OBikePadmal/pslab-mini-hardware/schematic/pslab-mini.kicad_sch

## KiCad design schematic/pslab-mini.kicad_sch (2025-08-20)

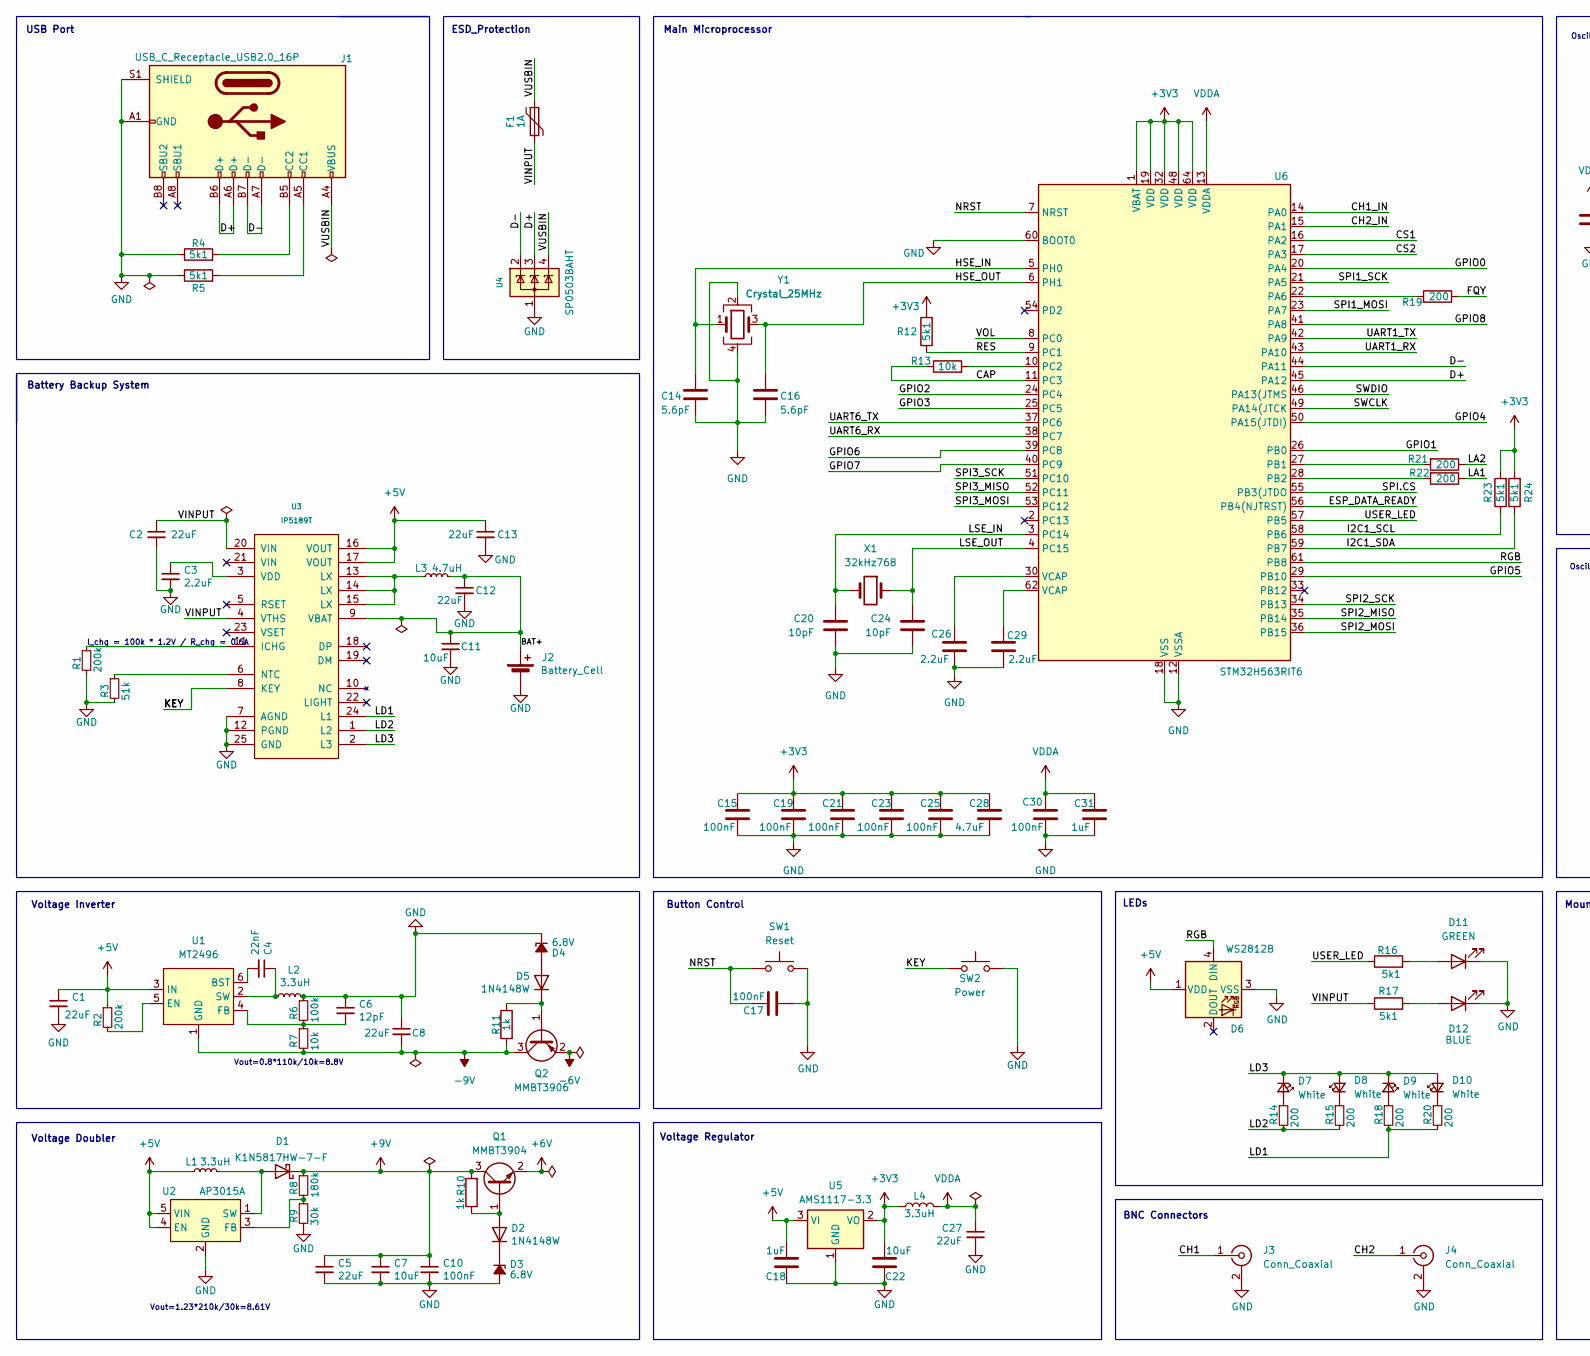
[picture p1: schematic pslab-mini.kicad_sch, part in row 1, column 1]

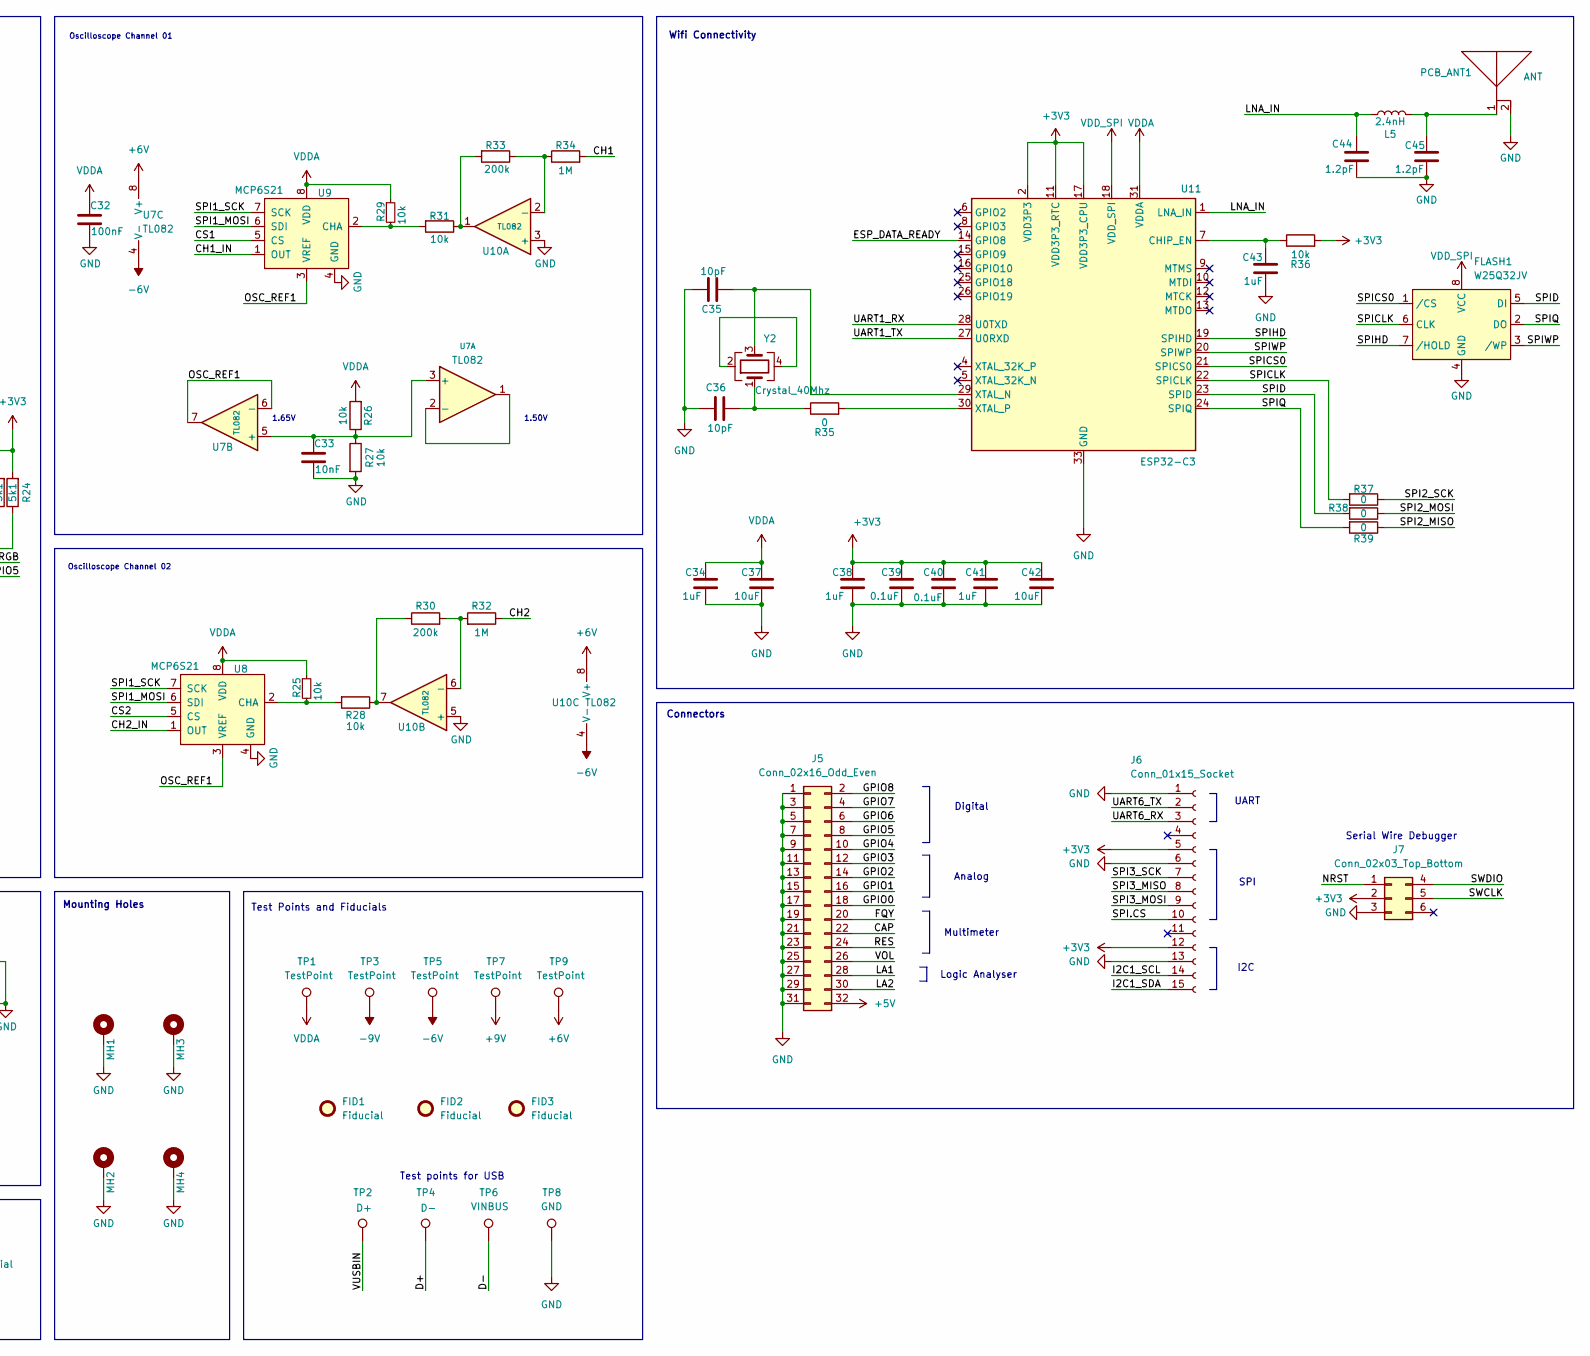
[picture p2: schematic pslab-mini.kicad_sch, part in row 1, column 2]

Parts:
C1, C2, C5, C8, C12, C13, C27: 22uF; C_0805_2012Metric; Part Number (LCSC) C602037
C3, C26, C29: 2.2uF; C_0805_2012Metric; Part Number (LCSC) C19110
C4: 22nF; C_0603_1608Metric; Part Number (LCSC) C21122
C6: 12pF; C_0603_1608Metric; Part Number (LCSC) C107034
C7, C11, C22, C37, C42: 10uF; C_0805_2012Metric; Part Number (LCSC) C1713
C10, C15, C17, C19, C21, C23, C25, C30, C32: 100nF; C_0603_1608Metric; Part Number (LCSC) C14663
C14, C16: 5.6pF; C_0603_1608Metric; Part Number (LCSC) C309464
C18, C31, C34, C38, C41, C43: 1uF; C_0603_1608Metric; Part Number (LCSC) C15849
C20, C24, C35, C36: 10pF; C_0603_1608Metric; Part Number (LCSC) C1634
C28: 4.7uF; C_0805_2012Metric; Part Number (LCSC) C98192
C33: 10nF; C_0603_1608Metric; Part Number (LCSC) C100042
C39, C40: 0.1uF; C_0603_1608Metric; Part Number (LCSC) C14663
C44, C45: 1.2pF; C_0603_1608Metric; Part Number (LCSC) C519098
D1: K1N5817HW-7-F; D_SOD-123; Part Number (LCSC) C2891703
D2, D5: 1N4148W; D_SOD-123; Part Number (LCSC) C241939
D3, D4: 6.8V; D_SOD-123; Part Number (LCSC) C132794
D6: WS2812B; LED_WS2812B_PLCC4_5.0x5.0mm_P3.2mm; Part Number (LCSC) C114586
D7, D8, D9, D10: White; LED_0603_1608Metric; Part Number (LCSC) C965808
D11: GREEN; LED_0805_2012Metric; Part Number (LCSC) C965815
D12: BLUE; LED_0805_2012Metric; Part Number (LCSC) C965817
F1: 1A; Fuse_1206_3216Metric; Part Number (LCSC) C22435907
FID1, FID2, FID3: Fiducial; Fiducial_0.5mm_Mask1.5mm
FLASH1: W25Q32JV; SOIC-8_5.3x5.3mm_P1.27mm; Part Number (LCSC) C179173
J1: USB_C_Receptacle_USB2.0_16P; USB_C_Receptacle_G-Switch_GT-USB-7010ASV; Part Number (LCSC) C2988369
J2: Battery_Cell; 2.0mm_connector_edge; Part Number (LCSC) C295747
J3, J4: Conn_Coaxial; BNC_connector_dosinconn DOSIN-801-0050; Part Number (LCSC) C521210
J5: Conn_02x16_Odd_Even; PinSocket_2x16_P2.54mm_Vertical; Part Number (LCSC) C2883989
J6: Conn_01x15_Socket; PinSocket_1x15_P2.54mm_Vertical; Part Number (LCSC) C2932676
J7: Conn_02x03_Top_Bottom; pslab-mini_2x03_P2.54mm
L1, L2, L4: 3.3uH; L_0603_1608Metric; Part Number (LCSC) C162581
L3: 4.7uH; L_0805_2012Metric; Part Number (LCSC) C131082
L5: 2.4nH; L_0402_1005Metric; Part Number (LCSC) C404619
MH1, MH2, MH3, MH4: MountingHole_Pad; MountingHole_2.75mm_Pad
PCB_ANT1: ANT; D_1206_3216Metric; Part Number (LCSC) C127620
Q1: MMBT3904; SOT-23; Part Number (LCSC) C81464
Q2: MMBT3906; SOT-23; Part Number (LCSC) C727128
R1, R2, R30, R33: 200k; R_0603_1608Metric; Part Number (LCSC) C105574
R3: 51k; R_0603_1608Metric; Part Number (LCSC) C107231
R4, R5, R12, R16, R17, R23, R24: 5k1; R_0603_1608Metric; Part Number (LCSC) C105580
R6: 100k; R_0603_1608Metric; Part Number (LCSC) C14675
R7, R13, R25, R26, R27, R28, R29, R31, R36: 10k; R_0603_1608Metric; Part Number (LCSC) C98220
R8: 180k; R_0603_1608Metric; Part Number (LCSC) C123419
R9: 30k; R_0603_1608Metric; Part Number (LCSC) C723585
R10, R11: 1k; R_0603_1608Metric; Part Number (LCSC) C22548
R14, R15, R18, R20: 200; R_0402_1005Metric; Part Number (LCSC) C114764
R19, R21, R22: 200; R_0603_1608Metric; Part Number (LCSC) C114664
R32, R34: 1M; R_0603_1608Metric; Part Number (LCSC) C105578
R35, R37, R38, R39: 0; R_0603_1608Metric; Part Number (LCSC) C95177
SW1: Reset; SW_Tactile_SPST_NO_Straight_CK_PTS636Sx25SMTRLFS; Part Number (LCSC) C2689642
SW2: Power; SW_Tactile_SPST_NO_Straight_CK_PTS636Sx25SMTRLFS; Part Number (LCSC) C2689642
TP1, TP3, TP5, TP7, TP9: TestPoint; Test_Point_0.8mm
TP2: D+; TestPoint_Pad_1.0x1.0mm
TP4: D-; TestPoint_Pad_1.0x1.0mm
TP6: VINBUS; TestPoint_Pad_1.0x1.0mm
TP8: GND; TestPoint_Pad_1.0x1.0mm
U1: MT2496; SOT-23-6; Part Number (LCSC) C384594
U2: AP3015A; SOT-23-5; Part Number (LCSC) C154879
U3: IP5189T; QFN-24-1EP_4x4mm_P0.5mm_EP2.6x2.6mm; Part Number (LCSC) C181698
U4: SP0503BAHT; SOT-143; Part Number (LCSC) C7074
U5: AMS1117-3.3; SOT-223-3_TabPin2; Part Number (LCSC) C6186
U6: STM32H563RIT6; LQFP-64_10x10mm_P0.5mm; Part Number (LCSC) C20619634
U7, U10: TL082; SOIC-8_3.9x4.9mm_P1.27mm; Part Number (LCSC) C9385
U8, U9: MCP6S21; SOIC-8_3.9x4.9mm_P1.27mm; Part Number (LCSC) C144187
U11: ESP32-C3; QFN-32-1EP_5x5mm_P0.5mm_EP3.7x3.7mm; Part Number (LCSC) C2838500
X1: 32kHz768; Crystal_SMD_3215-2Pin_3.2x1.5mm; Part Number (LCSC) C32346
Y1: Crystal_25MHz; Crystal_SMD_3225-4Pin_3.2x2.5mm; Part Number (LCSC) C9006
Y2: Crystal_40Mhz; Crystal_SMD_3225-4Pin_3.2x2.5mm; Part Number (LCSC) C5261245

Connections:
+3V3: C15.1, C19.1, C21.1, C22.2, C23.1, C25.1, C28.1, C38.1, C39.1, C40.1, C41.1, C42.1, J6.5, J6.12, J7.2, L4.2, R12.2, R23.2, R24.2, R36.2, U5.2 (VO), U6.1 (VBAT), U6.19 (VDD), U6.32 (VDD), U6.48 (VDD), U6.64 (VDD), U11.2 (VDD3P3), U11.3 (VDD3P3), U11.11 (VDD3P3_RTC), U11.17 (VDD3P3_CPU)
+5V: C1.1, C13.1, C18.2, D6.1 (VDD), J5.32, L1.1, R2.1, U1.3 (IN), U2.4 (EN), U2.5 (VIN), U3.16 (VOUT), U3.17 (VOUT), U5.3 (VI)
+6V: Q1.2 (E), TP9.1, U7.8 (V+), U10.8 (V+)
+9V: C5.1, C7.1, C10.1, D1.1 (K), Q1.3 (C), R8.1, R10.2, TP7.1
-6V: Q2.2 (E), TP5.1, U7.4 (V-), U10.4 (V-)
-9V: C8.2, Q2.3 (C), R7.2, R11.2, TP3.1, U1.1 (GND)
BAT+: C11.1, C12.1, J2.1 (+), L3.2, U3.9 (VBAT)
CAP: J5.22, R13.1, U6.11 (PC3)
CH1: J3.1 (In), R34.2
CH1_IN: U6.14 (PA0), U9.1 (OUT)
CH2: J4.1 (In), R32.1
CH2_IN: U6.15 (PA1), U8.1 (OUT)
CS1: U6.16 (PA2), U9.5 (CS)
CS2: U6.17 (PA3), U8.5 (CS)
D+: J1.A6 (D+), J1.B6 (D+), TP4.1, U4.3 (K), U6.45 (PA12)
D-: J1.A7 (D-), J1.B7 (D-), TP6.1, U4.2 (K), U6.44 (PA11)
ESP_DATA_READY: U6.56 (PB4(NJTRST)), U11.14 (GPIO8)
FQY: J5.20, R19.1
GND: C1.2, C2.2, C3.2, C5.2, C6.1, C7.2, C8.1, C10.2, C11.2, C12.2, C13.2, C14.2, C15.2, C16.2, C17.2, C18.1, C19.2, C20.2, C21.2, C22.1, C23.2, C24.2, C25.2, C26.2, C27.2, C28.2, C29.2, C30.2, C31.2, C32.2, C33.2, C34.2, C35.1, C36.1, C37.2, C38.2, C39.2, C40.2, C41.2, C42.2, C43.2, C44.2, C45.2, D3.2 (A), D4.1 (K), D6.3 (VSS), D11.1 (K), D12.1 (K), FLASH1.4 (GND), J1.A1 (GND), J1.A12 (GND), J1.B1 (GND), J1.B12 (GND), J1.S1 (SHIELD), J2.2 (-), J3.2 (Ext), J4.2 (Ext), J5.1, J5.3, J5.5, J5.7, J5.9, J5.11, J5.13, J5.15, J5.17, J5.19, J5.21, J5.23, J5.25, J5.27, J5.29, J5.31, J6.1, J6.6, J6.13, J7.3, L2.2, MH1.1, MH2.1, MH3.1, MH4.1, PCB_ANT1.2, R1.2, R3.2, R4.1, R5.1, R6.1, R9.2, R27.2, SW1.2, SW2.1, TP8.1, U2.2 (GND), U3.7 (AGND), U3.12 (PGND), U3.25 (GND), U4.1 (A), U5.1 (GND), U6.12 (VSSA), U6.18 (VSS), U6.31 (VSS), U6.47 (VSS), U6.60 (BOOT0), U6.63 (VSS), U8.4 (GND), U9.4 (GND), U10.3 (+), U10.5 (+), U11.33 (GND), Y1.2, Y1.4
GPIO0: J5.18, U6.20 (PA4)
GPIO1: J5.16, U6.26 (PB0)
GPIO2: J5.14, U6.24 (PC4)
GPIO3: J5.12, U6.25 (PC5)
GPIO4: J5.10, U6.50 (PA15(JTDI))
GPIO5: J5.8, U6.29 (PB10)
GPIO6: J5.6, U6.39 (PC8)
GPIO7: J5.4, U6.40 (PC9)
GPIO8: J5.2, U6.41 (PA8)
HSE_IN: C14.1, U6.5 (PH0), Y1.1
HSE_OUT: C16.1, U6.6 (PH1), Y1.3
I2C1_SCL: J6.14, R23.1, U6.58 (PB6)
I2C1_SDA: J6.15, R24.1, U6.59 (PB7)
KEY: SW2.2, U3.8 (KEY)
LA1: J5.28, R22.1
LA2: J5.30, R21.1
LD1: R18.2, R20.2, U3.24 (L1)
LD2: R14.2, R15.2, U3.1 (L2)
LD3: D7.1 (K), D8.2 (A), D9.1 (K), D10.2 (A), U3.2 (L3)
LNA_IN: C44.1, L5.2, U11.1 (LNA_IN)
LSE_IN: C20.1, U6.3 (PC14), X1.2
LSE_OUT: C24.1, U6.4 (PC15), X1.1
NRST: C17.1, J7.1, SW1.1, U6.7 (NRST)
unnamed: C3.1, U3.3 (VDD)
unnamed: C4.1, L2.1, U1.2 (SW)
unnamed: C4.2, U1.6 (BST)
unnamed: C6.2, R6.2, R7.1, U1.4 (FB)
unnamed: C26.1, U6.30 (VCAP)
unnamed: C29.1, U6.62 (VCAP)
unnamed: C33.1, R26.1, R27.1, U7.3 (+), U7.5 (+)
unnamed: C35.2, U11.29 (XTAL_N), Y2.3
unnamed: C36.2, R35.1, Y2.1
unnamed: C43.1, R36.1, U11.7 (CHIP_EN)
unnamed: C45.1, L5.1, PCB_ANT1.1
unnamed: D1.2 (A), L1.2, U2.1 (SW)
unnamed: D2.1 (K), D3.1 (K)
unnamed: D2.2 (A), Q1.1 (B), R10.1
unnamed: D4.2 (A), D5.2 (A)
unnamed: D5.1 (K), Q2.1 (B), R11.1
unnamed: D7.2 (A), R14.1
unnamed: D8.1 (K), R15.1
unnamed: D9.2 (A), R18.1
unnamed: D10.1 (K), R20.1
unnamed: D11.2 (A), R16.2
unnamed: D12.2 (A), R17.2
unnamed: J1.A5 (CC1), R5.2
unnamed: J1.B5 (CC2), R4.2
unnamed: L3.1, U3.13 (LX), U3.14 (LX), U3.15 (LX)
unnamed: R1.1, U3.11 (ICHG)
unnamed: R2.2, U1.5 (EN)
unnamed: R3.1, U3.6 (NTC)
unnamed: R8.2, R9.1, U2.3 (FB)
unnamed: R13.2, U6.10 (PC2)
unnamed: R19.2, U6.22 (PA6)
unnamed: R21.2, U6.27 (PB1)
unnamed: R22.2, U6.28 (PB2)
unnamed: R25.2, R28.2, U8.2 (CHA)
unnamed: R28.1, R30.1, U10.7
unnamed: R29.2, R31.2, U9.2 (CHA)
unnamed: R30.2, R32.2, U10.6 (-)
unnamed: R31.1, R33.2, U10.1
unnamed: R33.1, R34.1, U10.2 (-)
unnamed: R35.2, U11.30 (XTAL_P)
unnamed: U7.1, U7.2 (-)
unnamed: Y2.2, Y2.4
OSC_REF1: U7.6 (-), U7.7, U8.3 (VREF), U9.3 (VREF)
RES: J5.24, R12.1, U6.9 (PC1)
RGB: D6.4 (DIN), U6.61 (PB8)
SPI1_MOSI: U6.23 (PA7), U8.6 (SDI), U9.6 (SDI)
SPI1_SCK: U6.21 (PA5), U8.7 (SCK), U9.7 (SCK)
SPI2_MISO: R39.1, U6.35 (PB14)
SPI2_MOSI: R38.1, U6.36 (PB15)
SPI2_SCK: R37.1, U6.34 (PB13)
SPI3_MISO: J6.8, U6.52 (PC11)
SPI3_MOSI: J6.9, U6.53 (PC12)
SPI3_SCK: J6.7, U6.51 (PC10)
SPI.CS: J6.10, U6.55 (PB3(JTDO)
SPICLK: FLASH1.6 (CLK), R37.2, U11.22 (SPICLK)
SPICS0: FLASH1.1 (/CS), U11.21 (SPICS0)
SPID: FLASH1.5 (DI), R38.2, U11.23 (SPID)
SPIHD: FLASH1.7 (/HOLD), U11.19 (SPIHD)
SPIQ: FLASH1.2 (DO), R39.2, U11.24 (SPIQ)
SPIWP: FLASH1.3 (/WP), U11.20 (SPIWP)
SWCLK: J7.5, U6.49 (PA14(JTCK)
SWDIO: J7.4, U6.46 (PA13(JTMS)
UART1_RX: U6.43 (PA10), U11.28 (U0TXD)
UART1_TX: U6.42 (PA9), U11.27 (U0RXD)
UART6_RX: J6.3, U6.38 (PC7)
UART6_TX: J6.2, U6.37 (PC6)
USER_LED: R16.1, U6.57 (PB5)
VDDA: C27.1, C30.1, C31.1, C32.1, C34.1, C37.1, L4.1, R25.1, R26.2, R29.1, TP1.1, U6.13 (VDDA), U8.8 (VDD), U9.8 (VDD), U11.31 (VDDA), U11.32 (VDDA)
VDD_SPI: FLASH1.8 (VCC), U11.18 (VDD_SPI)
VINPUT: C2.1, F1.2, R17.1, U3.4 (VTHS), U3.20 (VIN)
VOL: J5.26, U6.8 (PC0)
VUSBIN: F1.1, J1.A4 (VBUS), J1.A9 (VBUS), J1.B4 (VBUS), J1.B9 (VBUS), TP2.1, U4.4 (K)

Notes on the sheet:
Voltage Regulator
Battery Backup System
Test Points and Fiducials
I2C
Connectors
SPI
Oscilloscope Channel 01
UART
Multimeter
Vout=0.8*110k/10k=8.8V
1.65V
Analog
Button Control
Voltage Doubler
BNC Connectors
1.50V
Serial Wire Debugger
ESD_Protection
Main Microprocessor
Voltage Inverter
Logic Analyser
LEDs
Vout=1.23*210k/30k=8.61V
Mounting Holes
Test points for USB
I_chg = 100k * 1.2V / R_chg = 0.6A
USB Port
Digital
Wifi Connectivity
Oscilloscope Channel 02
